karantrehan3/Arithmetic-Logic-Unit/(list of files, drawings)

Other design files:
DE LAB PROJECT.pdsprj
